poojariutkarsh1/SIH_prototype_2026/(commit log)

2026-09-07 Add sensor functionality for Minelander safety system
    This file implements a safety system for the Minelander robot using various sensors, including an ultrasonic sensor and an MPU6050 for motion detection. It includes functionality for reading sensor data, calculating distances, and determining safety actions based on environmental conditions.
2026-09-07 Add Minelander ESP8266 bot control logic
    This file contains the implementation of the Minelander ESP8266 bot, including motor control, LED, and buzzer functionalities. It defines pin configurations, setup routines, and command handling for safe, caution, and danger modes.
    [output.ino]
2026-09-07 Refactor buzzer control to use digitalWrite
    [output.ino]
2026-09-07 Refactor motor control and command handling
    Updated motor control logic and pin definitions for ESP8266 integration. Improved command handling and buzzer functionality.
    [output.ino]
2026-09-07 Update sensor pins and fog state in sensor.ino
2026-09-07 Add sensor_with_bme.ino for fog risk assessment
2026-09-20 Create lidar
2026-09-20 Add launch file for Lidar and RViz integration
2026-09-20 Add initial lidar_view.rviz configuration file
2026-09-20 Add setup configuration for Lidar package
2026-09-20 Add ROS2 LiDAR TTC simulation
    [robot.urdf]
2026-09-20 Add gimbal control code using MPU6050 and Servo
